benthacher/alarmbot/README.md

# Alarmbot project

## Alarmbot PCB

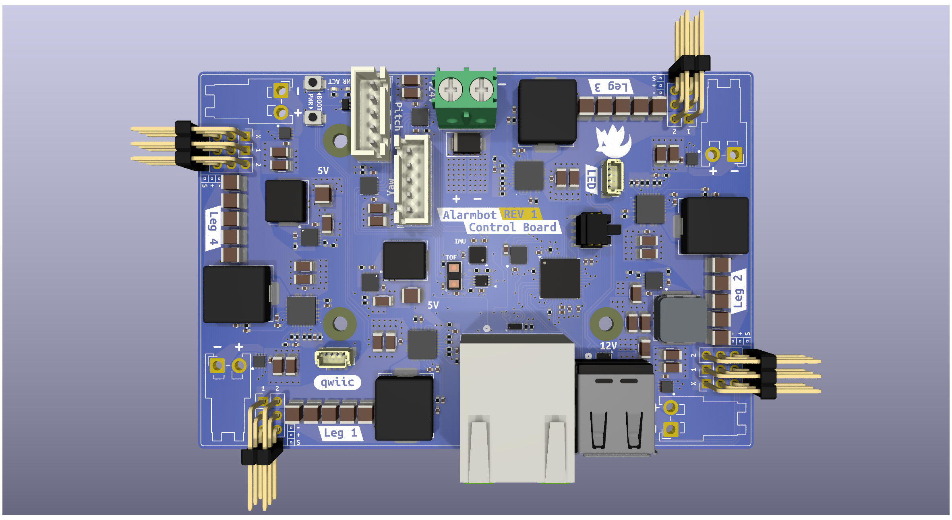
[picture p1: pcb/alarmbot.png]
alarmbot
