benthacher/alarmbot/pcb/alarmbot.kicad_pcb

## KiCad design pcb/alarmbot.kicad_pcb (2025-03-19)

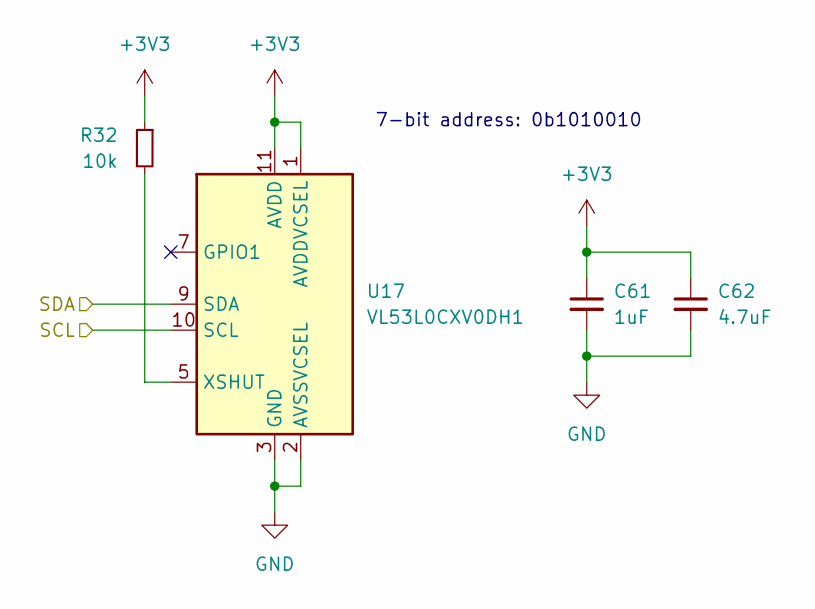
[picture p2: schematic tof.kicad_sch]

Parts:
C61: 1uF; C_0402_1005Metric; LCSC C52923
C62: 4.7uF; C_0402_1005Metric; LCSC C23733
R32: 10k; R_0402_1005Metric; LCSC C25744
U17: VL53L0CXV0DH1; ST_VL53L1x; LCSC C91199

Connections:
+3V3: C61.1, C62.1, R32.1, U17.1 (AVDDVCSEL), U17.11 (AVDD); also elsewhere on the board
/MCU/I2C2_SCL: U17.10 (SCL); also elsewhere on the board
/MCU/I2C2_SDA: U17.9 (SDA); also elsewhere on the board
GND: C61.2, C62.2, U17.2 (AVSSVCSEL), U17.3 (GND), U17.4 (GND), U17.6 (GND), U17.12 (GND); also elsewhere on the board
unnamed: R32.2, U17.5 (XSHUT)

Notes on the sheet:
7-bit address: 0b1010010

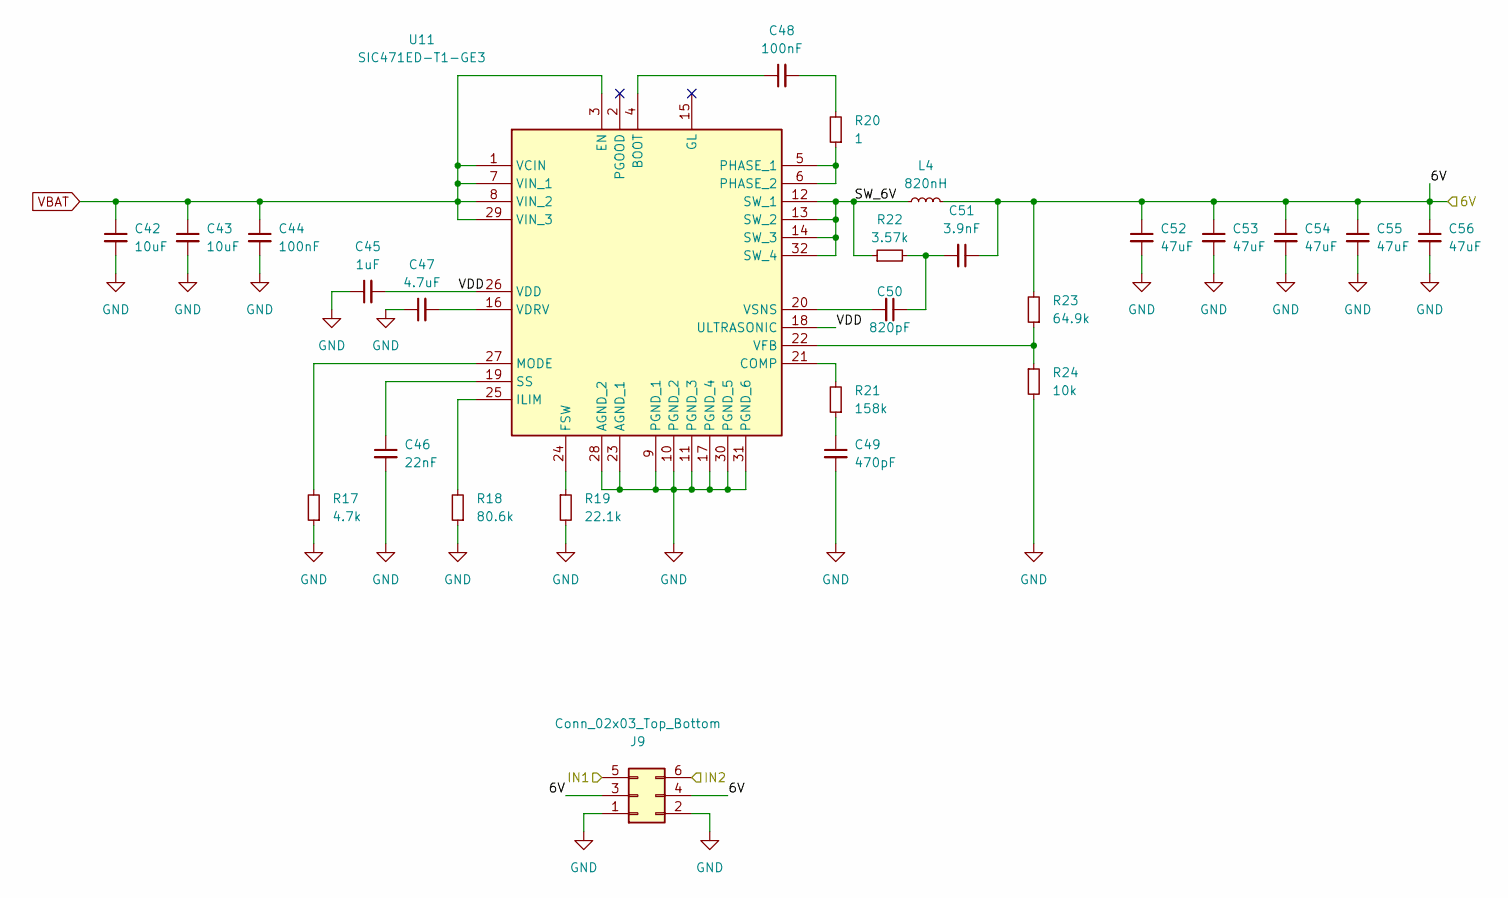
[picture p3: schematic shoulder.kicad_sch]

Parts:
C42, C43: 10uF; C_1206_3216Metric; LCSC C13585
C44, C48: 100nF; C_0402_1005Metric; Voltage 50V; LCSC C307331
C45: 1uF; C_0402_1005Metric; LCSC C52923
C46: 22nF; C_0402_1005Metric; LCSC C1532
C47: 4.7uF; C_0402_1005Metric; LCSC C23733
C49: 470pF; C_0402_1005Metric; LCSC C1537
C50: 820pF; C_0402_1005Metric; LCSC C107031
C51: 3.9nF; C_0402_1005Metric; LCSC C45188
C52, C53, C54, C55, C56: 47uF; C_1210_3225Metric; LCSC C5440143
J9: Conn_02x03_Top_Bottom; PinHeader_2x03_P2.54mm_Vertical
L4: 820nH; CMPI1040; LCSC C7588944
R17: 4.7k; R_0402_1005Metric; LCSC C25900
R18: 80.6k; R_0402_1005Metric; LCSC C25921
R19: 22.1k; R_0402_1005Metric; LCSC C43473
R20: 1; R_0402_1005Metric; LCSC C25086
R21: 158k; R_0402_1005Metric; LCSC C185464
R22: 3.57k; R_0402_1005Metric; LCSC C3037168
R23: 64.9k; R_0402_1005Metric; LCSC C5713275
R24: 10k; R_0402_1005Metric; LCSC C25744
U11: SIC471ED-T1-GE3; SIC471EDT1GE3; Manufacturer_Part_Number SIC471ED-T1-GE3; Mouser Part Number 78-SIC471ED-T1-GE3

Connections:
/MCU/TIM2_CH1: J9.5; also elsewhere on the board
/MCU/TIM2_CH2: J9.6; also elsewhere on the board
/Shoulder1/6V: C51.1, C52.1, C53.1, C54.1, C55.1, C56.1, J9.3, J9.4, L4.2, R23.2
/Shoulder1/SW_6V: L4.1, R22.1, U11.12 (SW_1), U11.13 (SW_2), U11.14 (SW_3), U11.32 (SW_4)
/Shoulder1/VDD: C45.2, U11.18 (ULTRASONIC), U11.26 (VDD)
GND: C42.2, C43.2, C44.2, C45.1, C46.2, C47.1, C49.2, C52.2, C53.2, C54.2, C55.2, C56.2, J9.1, J9.2, R17.1, R18.1, R19.2, R24.2, U11.9 (PGND_1), U11.10 (PGND_2), U11.11 (PGND_3), U11.17 (PGND_4), U11.23 (AGND_1), U11.28 (AGND_2), U11.30 (PGND_5), U11.31 (PGND_6); also elsewhere on the board
unnamed: C48.2, R20.2
unnamed: C49.1, R21.1
unnamed: C50.1, C51.2, R22.2
unnamed: C48.1, U11.4 (BOOT)
unnamed: R21.2, U11.21 (COMP)
unnamed: R19.1, U11.24 (FSW)
unnamed: R18.2, U11.25 (ILIM)
unnamed: R17.2, U11.27 (MODE)
unnamed: R20.1, U11.5 (PHASE_1), U11.6 (PHASE_2)
unnamed: C46.1, U11.19 (SS)
unnamed: C47.2, U11.16 (VDRV)
unnamed: R23.1, R24.1, U11.22 (VFB)
unnamed: C50.2, U11.20 (VSNS)
VBAT: C42.1, C43.1, C44.1, U11.1 (VCIN), U11.3 (EN), U11.7 (VIN_1), U11.8 (VIN_2), U11.29 (VIN_3); also elsewhere on the board

Parts of its further copies:
C63, C64, C78, C79, C93, C94: 10uF; C_1206_3216Metric; LCSC C13585
C65, C69, C80, C84, C95, C99: 100nF; C_0402_1005Metric; Voltage 50V; LCSC C307331
C66, C81, C96: 1uF; C_0402_1005Metric; LCSC C52923
C67, C82, C97: 22nF; C_0402_1005Metric; LCSC C1532
C68, C83, C98: 4.7uF; C_0402_1005Metric; LCSC C23733
C70, C85, C100: 470pF; C_0402_1005Metric; LCSC C1537
C71, C86, C101: 820pF; C_0402_1005Metric; LCSC C107031
C72, C87, C102: 3.9nF; C_0402_1005Metric; LCSC C45188
C73, C74, C75, C76, C77, C88, C89, C90, C91, C92, C103, C104, C105, C106, C107: 47uF; C_1210_3225Metric; LCSC C5440143
J13, J14, J15: Conn_02x03_Top_Bottom; PinHeader_2x03_P2.54mm_Vertical
L5, L6, L7: 820nH; CMPI1040; LCSC C7588944
R33, R41, R49: 4.7k; R_0402_1005Metric; LCSC C25900
R34, R42, R50: 80.6k; R_0402_1005Metric; LCSC C25921
R35, R43, R51: 22.1k; R_0402_1005Metric; LCSC C43473
R36, R44, R52: 1; R_0402_1005Metric; LCSC C25086
R37, R45, R53: 158k; R_0402_1005Metric; LCSC C185464
R38, R46, R54: 3.57k; R_0402_1005Metric; LCSC C3037168
R39, R47, R55: 64.9k; R_0402_1005Metric; LCSC C5713275
R40, R48, R56: 10k; R_0402_1005Metric; LCSC C25744
U18, U19, U20: SIC471ED-T1-GE3; SIC471EDT1GE3; Manufacturer_Part_Number SIC471ED-T1-GE3; Mouser Part Number 78-SIC471ED-T1-GE3

Connections of its further copies:
/MCU/TIM1_CH1: J14.5; also elsewhere on the board
/MCU/TIM1_CH2: J14.6; also elsewhere on the board
/MCU/TIM1_CH3: J15.5; also elsewhere on the board
/MCU/TIM1_CH4: J15.6; also elsewhere on the board
/MCU/TIM2_CH3: J13.5; also elsewhere on the board
/MCU/TIM2_CH4: J13.6; also elsewhere on the board
/Shoulder2/6V: C72.1, C73.1, C74.1, C75.1, C76.1, C77.1, J13.3, J13.4, L5.2, R39.2; also elsewhere on the board
/Shoulder2/SW_6V: L5.1, R38.1, U18.12 (SW_1), U18.13 (SW_2), U18.14 (SW_3), U18.32 (SW_4)
/Shoulder2/VDD: C66.2, U18.18 (ULTRASONIC), U18.26 (VDD)
/Shoulder3/6V: C87.1, C88.1, C89.1, C90.1, C91.1, C92.1, J14.3, J14.4, L6.2, R47.2
/Shoulder3/SW_6V: L6.1, R46.1, U19.12 (SW_1), U19.13 (SW_2), U19.14 (SW_3), U19.32 (SW_4)
/Shoulder3/VDD: C81.2, U19.18 (ULTRASONIC), U19.26 (VDD)
/Shoulder4/6V: C102.1, C103.1, C104.1, C105.1, C106.1, C107.1, J15.3, J15.4, L7.2, R55.2; also elsewhere on the board
/Shoulder4/SW_6V: L7.1, R54.1, U20.12 (SW_1), U20.13 (SW_2), U20.14 (SW_3), U20.32 (SW_4)
/Shoulder4/VDD: C96.2, U20.18 (ULTRASONIC), U20.26 (VDD)
GND: C63.2, C64.2, C65.2, C66.1, C67.2, C68.1, C70.2, C73.2, C74.2, C75.2, C76.2, C77.2, C78.2, C79.2, C80.2, C81.1, C82.2, C83.1, C85.2, C88.2, C89.2, C90.2, C91.2, C92.2, C93.2, C94.2, C95.2, C96.1, C97.2, C98.1, C100.2, C103.2, C104.2, C105.2, C106.2, C107.2, J13.1, J13.2, J14.1, J14.2, J15.1, J15.2, R33.1, R34.1, R35.2, R40.2, R41.1, R42.1, R43.2, R48.2, R49.1, R50.1, R51.2, R56.2, U18.9 (PGND_1), U18.10 (PGND_2), U18.11 (PGND_3), U18.17 (PGND_4), U18.23 (AGND_1), U18.28 (AGND_2), U18.30 (PGND_5), U18.31 (PGND_6), U19.9 (PGND_1), U19.10 (PGND_2), U19.11 (PGND_3), U19.17 (PGND_4), U19.23 (AGND_1), U19.28 (AGND_2), U19.30 (PGND_5), U19.31 (PGND_6), U20.9 (PGND_1), U20.10 (PGND_2), U20.11 (PGND_3), U20.17 (PGND_4), U20.23 (AGND_1), U20.28 (AGND_2), U20.30 (PGND_5), U20.31 (PGND_6); also elsewhere on the board
unnamed: C69.2, R36.2
unnamed: C70.1, R37.1
unnamed: C71.1, C72.2, R38.2
unnamed: C84.2, R44.2
unnamed: C85.1, R45.1
unnamed: C86.1, C87.2, R46.2
unnamed: C99.2, R52.2
unnamed: C100.1, R53.1
unnamed: C101.1, C102.2, R54.2
unnamed: C69.1, U18.4 (BOOT)
unnamed: R37.2, U18.21 (COMP)
unnamed: R35.1, U18.24 (FSW)
unnamed: R34.2, U18.25 (ILIM)
unnamed: R33.2, U18.27 (MODE)
unnamed: R36.1, U18.5 (PHASE_1), U18.6 (PHASE_2)
unnamed: C67.1, U18.19 (SS)
unnamed: C68.2, U18.16 (VDRV)
unnamed: R39.1, R40.1, U18.22 (VFB)
unnamed: C71.2, U18.20 (VSNS)
unnamed: C84.1, U19.4 (BOOT)
unnamed: R45.2, U19.21 (COMP)
unnamed: R43.1, U19.24 (FSW)
unnamed: R42.2, U19.25 (ILIM)
unnamed: R41.2, U19.27 (MODE)
unnamed: R44.1, U19.5 (PHASE_1), U19.6 (PHASE_2)
unnamed: C82.1, U19.19 (SS)
unnamed: C83.2, U19.16 (VDRV)
unnamed: R47.1, R48.1, U19.22 (VFB)
unnamed: C86.2, U19.20 (VSNS)
unnamed: C99.1, U20.4 (BOOT)
unnamed: R53.2, U20.21 (COMP)
unnamed: R51.1, U20.24 (FSW)
unnamed: R50.2, U20.25 (ILIM)
unnamed: R49.2, U20.27 (MODE)
unnamed: R52.1, U20.5 (PHASE_1), U20.6 (PHASE_2)
unnamed: C97.1, U20.19 (SS)
unnamed: C98.2, U20.16 (VDRV)
unnamed: R55.1, R56.1, U20.22 (VFB)
unnamed: C101.2, U20.20 (VSNS)
VBAT: C63.1, C64.1, C65.1, C78.1, C79.1, C80.1, C93.1, C94.1, C95.1, U18.1 (VCIN), U18.3 (EN), U18.7 (VIN_1), U18.8 (VIN_2), U18.29 (VIN_3), U19.1 (VCIN), U19.3 (EN), U19.7 (VIN_1), U19.8 (VIN_2), U19.29 (VIN_3), U20.1 (VCIN), U20.3 (EN), U20.7 (VIN_1), U20.8 (VIN_2), U20.29 (VIN_3); also elsewhere on the board

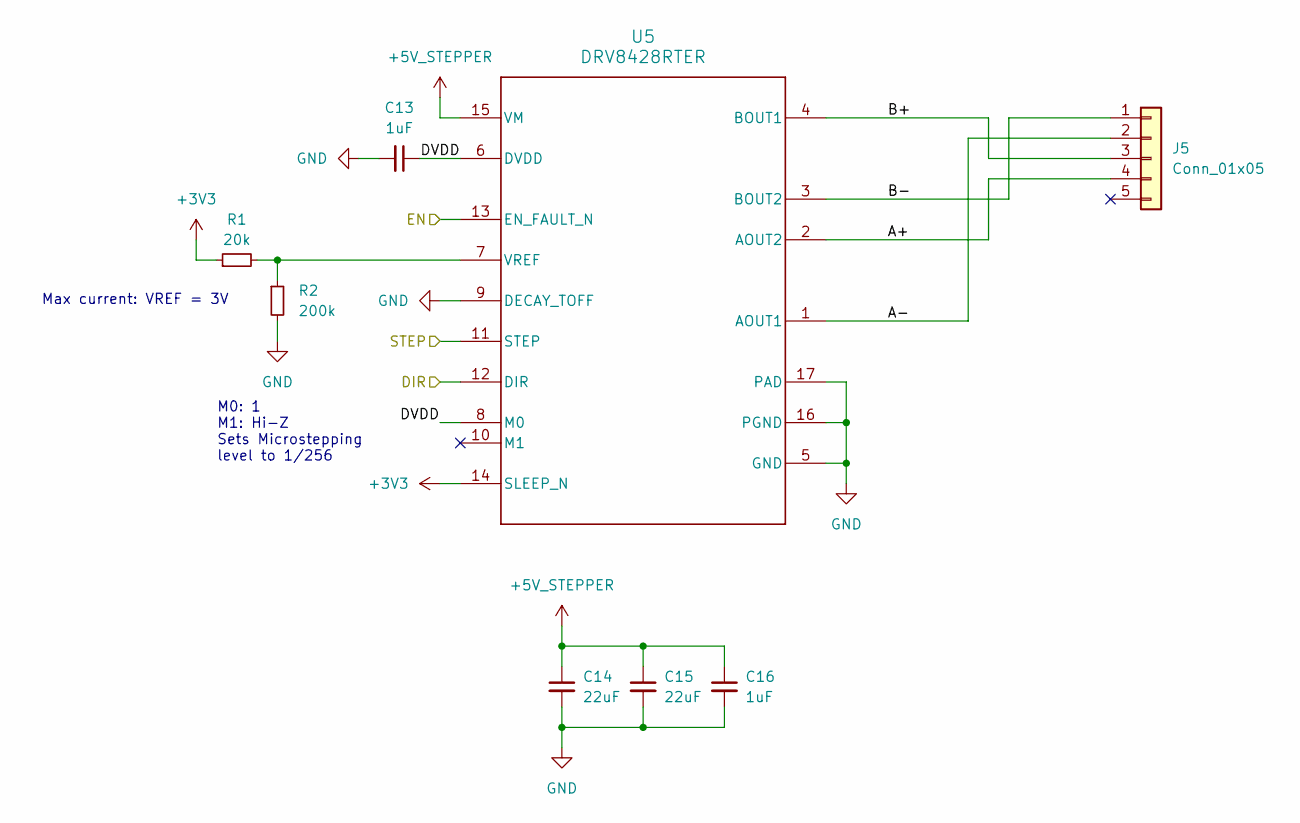
[picture p4: schematic stepper_motor_driver.kicad_sch]

Parts:
C13, C16: 1uF; C_0402_1005Metric; LCSC C52923
C14, C15: 22uF; C_1206_3216Metric; LCSC C12891
J5: Conn_01x05; JST_XH_B5B-XH-A_1x05_P2.50mm_Vertical
R1: 20k; R_0402_1005Metric; LCSC C25765
R2: 200k; R_0402_1005Metric; LCSC C25764
U5: DRV8428RTER; RTE0016J; LCSC C2857955

Connections:
+3V3: R1.1, U5.14 (SLEEP_N); also elsewhere on the board
+5V_STEPPER: C14.1, C15.1, C16.1, U5.15 (VM); also elsewhere on the board
/MCU/HEAD_PITCH_DIR: U5.12 (DIR); also elsewhere on the board
/MCU/HEAD_PITCH_EN: U5.13 (EN_FAULT_N); also elsewhere on the board
/MCU/TIM17_CH1: U5.11 (STEP); also elsewhere on the board
/Stepper1/A+: J5.4, U5.2 (AOUT2)
/Stepper1/A-: J5.2, U5.1 (AOUT1)
/Stepper1/B+: J5.3, U5.4 (BOUT1)
/Stepper1/B-: J5.1, U5.3 (BOUT2)
/Stepper1/DVDD: C13.1, U5.6 (DVDD), U5.8 (M0)
GND: C13.2, C14.2, C15.2, C16.2, R2.2, U5.5 (GND), U5.9 (DECAY_TOFF), U5.16 (PGND), U5.17 (PAD); also elsewhere on the board
unnamed: R1.2, R2.1, U5.7 (VREF)

Parts of its further copies:
C24, C27: 1uF; C_0402_1005Metric; LCSC C52923
C25, C26: 22uF; C_1206_3216Metric; LCSC C12891
J7: Conn_01x05; JST_XH_B5B-XH-A_1x05_P2.50mm_Vertical
R6: 20k; R_0402_1005Metric; LCSC C25765
R7: 200k; R_0402_1005Metric; LCSC C25764
U7: DRV8428RTER; RTE0016J; LCSC C2857955

Connections of its further copies:
+3V3: R6.1, U7.14 (SLEEP_N); also elsewhere on the board
+5V_STEPPER: C25.1, C26.1, C27.1, U7.15 (VM); also elsewhere on the board
/MCU/HEAD_YAW_DIR: U7.12 (DIR); also elsewhere on the board
/MCU/HEAD_YAW_EN: U7.13 (EN_FAULT_N); also elsewhere on the board
/MCU/TIM16_CH1: U7.11 (STEP); also elsewhere on the board
/Stepper2/A+: J7.4, U7.2 (AOUT2)
/Stepper2/A-: J7.2, U7.1 (AOUT1)
/Stepper2/B+: J7.3, U7.4 (BOUT1)
/Stepper2/B-: J7.1, U7.3 (BOUT2)
/Stepper2/DVDD: C24.1, U7.6 (DVDD), U7.8 (M0)
GND: C24.2, C25.2, C26.2, C27.2, R7.2, U7.5 (GND), U7.9 (DECAY_TOFF), U7.16 (PGND), U7.17 (PAD); also elsewhere on the board
unnamed: R6.2, R7.1, U7.7 (VREF)

Notes on the sheet:
M0: 1 M1: Hi-Z Sets Microstepping level to 1/256
Max current: VREF = 3V

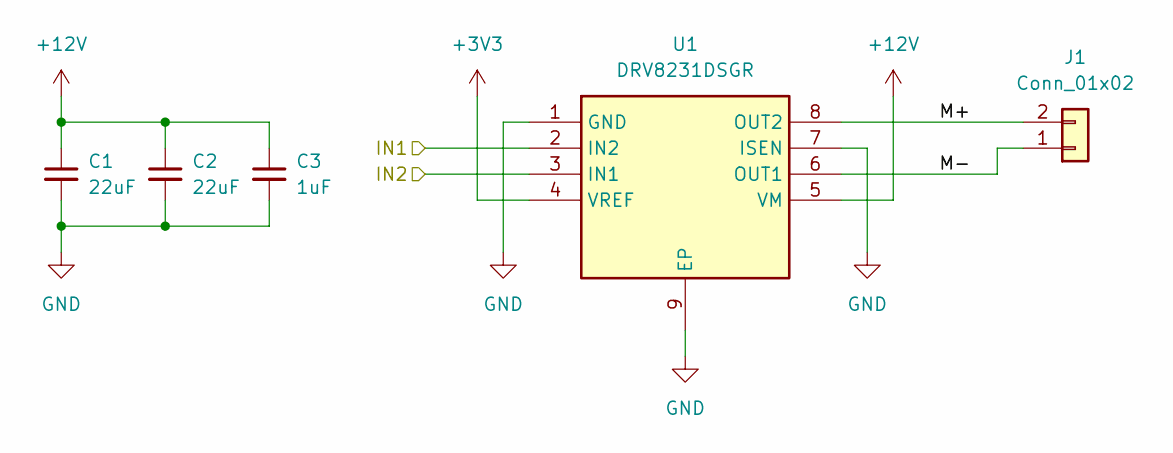
[picture p5: schematic wheel_motor_drive.kicad_sch]

Parts:
C1, C2: 22uF; C_1206_3216Metric; LCSC C12891
C3: 1uF; C_0402_1005Metric; LCSC C52923
J1: Conn_01x02; JST_VH_S2P-VH_1x02_P3.96mm_Horizontal; LCSC C158007
U1: DRV8231DSGR; SON50P200X200X80-9N; Manufacturer_Part_Number DRV8231DSGR; Mouser Part Number 595-DRV8231DSGR

Connections:
+3V3: U1.4 (VREF); also elsewhere on the board
+12V: C1.1, C2.1, C3.1, U1.5 (VM); also elsewhere on the board
/MCU/TIM3_CH1: U1.2 (IN2); also elsewhere on the board
/MCU/TIM3_CH2: U1.3 (IN1); also elsewhere on the board
/Wheel1/M+: J1.2, U1.8 (OUT2)
/Wheel1/M-: J1.1, U1.6 (OUT1)
GND: C1.2, C2.2, C3.2, U1.1 (GND), U1.7 (ISEN), U1.9 (EP); also elsewhere on the board

Parts of its further copies:
C4, C5, C7, C8, C10, C11: 22uF; C_1206_3216Metric; LCSC C12891
C6, C9, C12: 1uF; C_0402_1005Metric; LCSC C52923
J2, J3, J4: Conn_01x02; JST_VH_S2P-VH_1x02_P3.96mm_Horizontal; LCSC C158007
U2, U3, U4: DRV8231DSGR; SON50P200X200X80-9N; Manufacturer_Part_Number DRV8231DSGR; Mouser Part Number 595-DRV8231DSGR

Connections of its further copies:
+3V3: U2.4 (VREF), U3.4 (VREF), U4.4 (VREF); also elsewhere on the board
+12V: C4.1, C5.1, C6.1, C7.1, C8.1, C9.1, C10.1, C11.1, C12.1, U2.5 (VM), U3.5 (VM), U4.5 (VM); also elsewhere on the board
/MCU/TIM3_CH3: U2.2 (IN2); also elsewhere on the board
/MCU/TIM3_CH4: U2.3 (IN1); also elsewhere on the board
/MCU/TIM4_CH1: U3.2 (IN2); also elsewhere on the board
/MCU/TIM4_CH2: U3.3 (IN1); also elsewhere on the board
/MCU/TIM4_CH3: U4.2 (IN2); also elsewhere on the board
/MCU/TIM4_CH4: U4.3 (IN1); also elsewhere on the board
/Wheel2/M+: J2.2, U2.8 (OUT2)
/Wheel2/M-: J2.1, U2.6 (OUT1)
/Wheel3/M+: J3.2, U3.8 (OUT2)
/Wheel3/M-: J3.1, U3.6 (OUT1)
/Wheel4/M+: J4.2, U4.8 (OUT2)
/Wheel4/M-: J4.1, U4.6 (OUT1)
GND: C4.2, C5.2, C6.2, C7.2, C8.2, C9.2, C10.2, C11.2, C12.2, U2.1 (GND), U2.7 (ISEN), U2.9 (EP), U3.1 (GND), U3.7 (ISEN), U3.9 (EP), U4.1 (GND), U4.7 (ISEN), U4.9 (EP); also elsewhere on the board

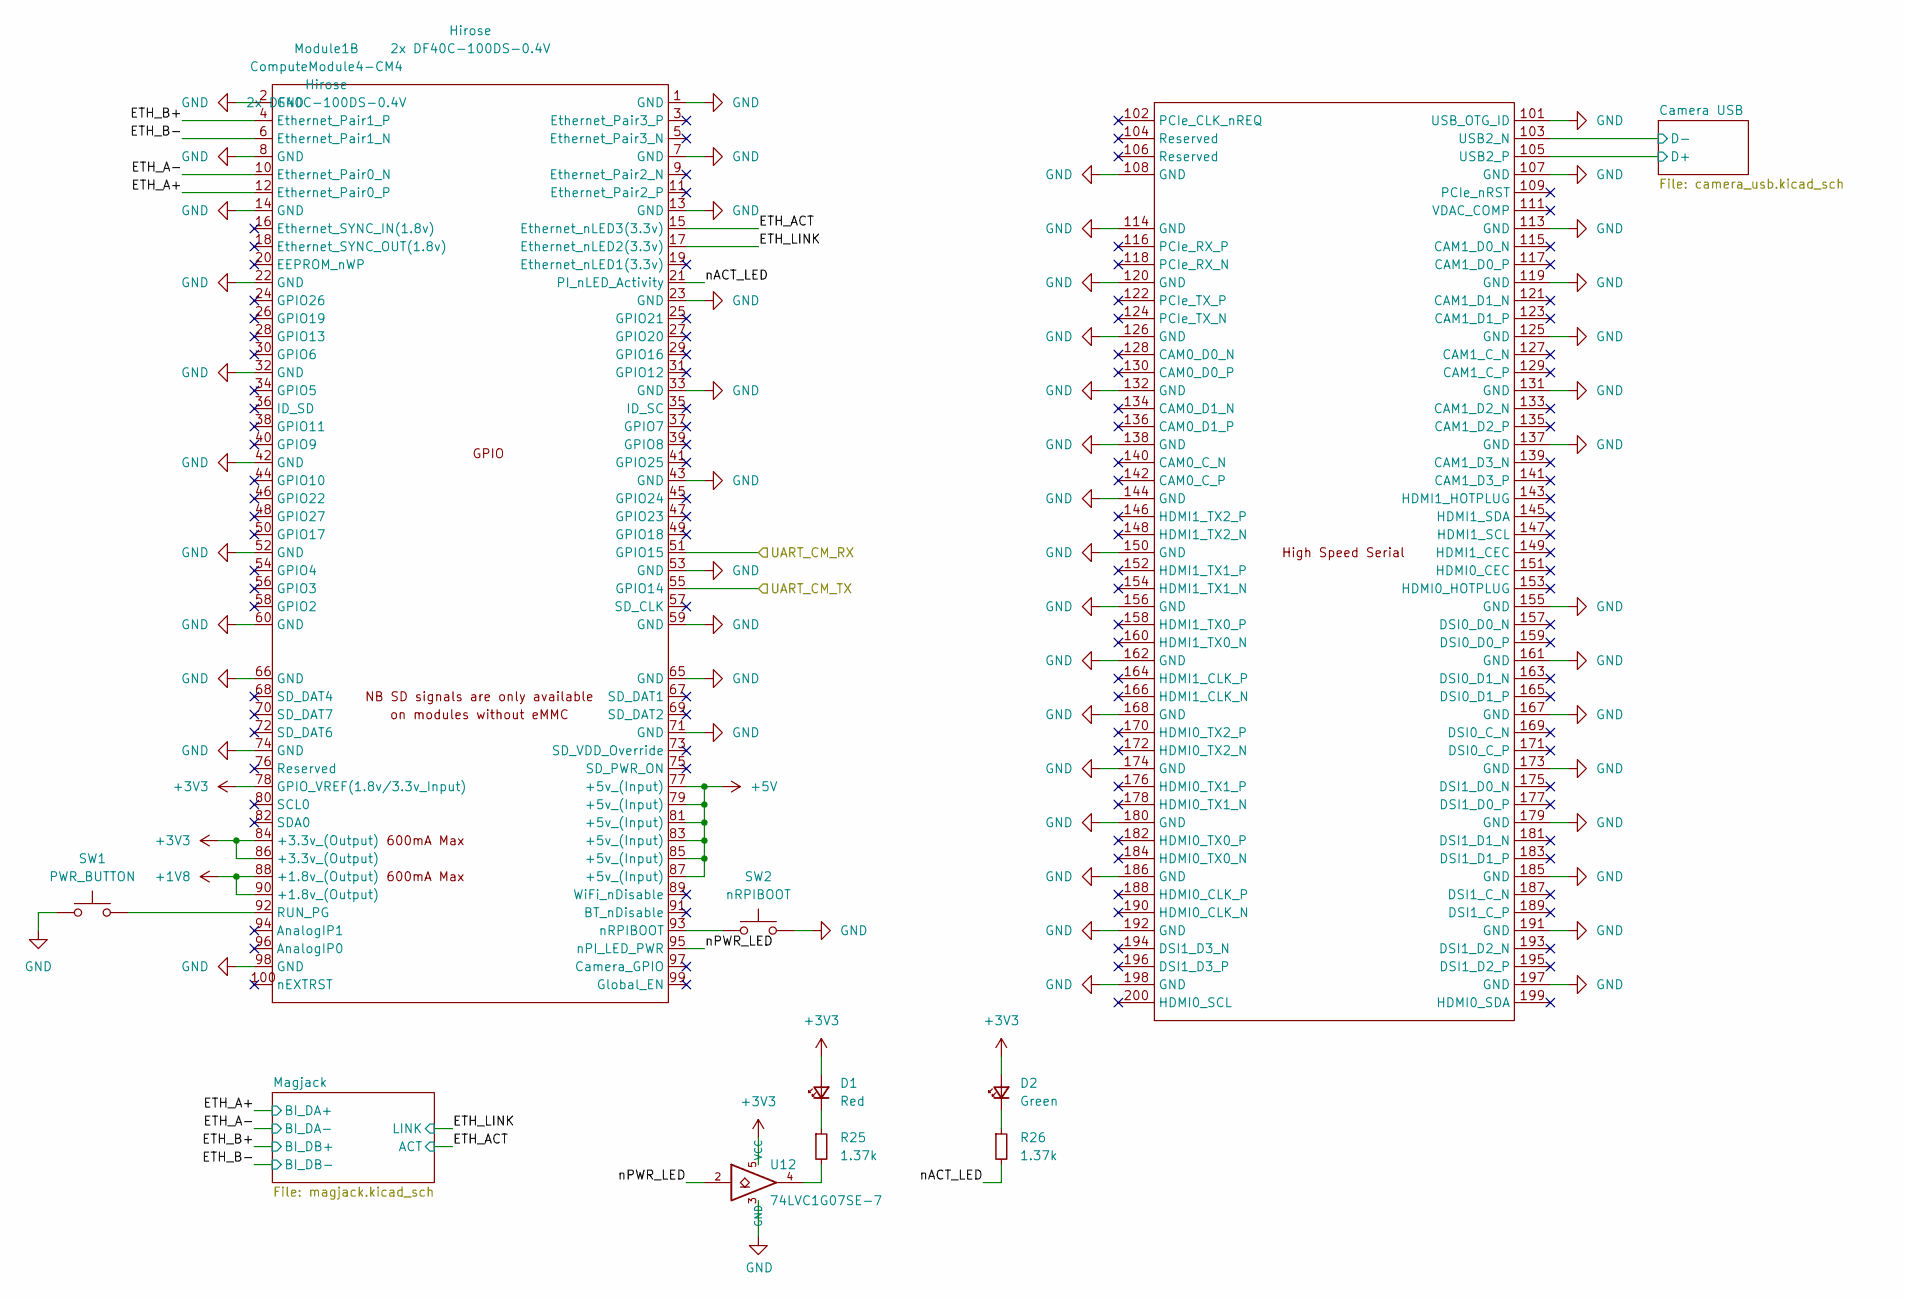
[picture p6: schematic cm5.kicad_sch]

Parts:
D1: Red; LED_0402_1005Metric; LCSC C264407
D2: Green; LED_0402_1005Metric; LCSC C401111
Module1: ComputeModule4-CM4; Raspberry-Pi-4-Compute-Module
R25, R26: 1.37k; R_0402_1005Metric; LCSC C321297
SW1: PWR_BUTTON; TL1017ABAF160QG
SW2: nRPIBOOT; TL1017ABAF160QG
U12: 74LVC1G07SE-7; SOT-353_SC-70-5; Part Description Buffer, Non-Inverting 1 Element 1 Bit p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; LCSC C264081

Connections:
+1V8: Module1.88 (+1.8v_(Output)), Module1.90 (+1.8v_(Output)); also elsewhere on the board
+3V3: D1.2 (A), D2.2 (A), Module1.78 (GPIO_VREF(1.8v/3.3v_Input)), Module1.84 (+3.3v_(Output)), Module1.86 (+3.3v_(Output)), U12.5 (VCC); also elsewhere on the board
+5V: Module1.77 (+5v_(Input)), Module1.79 (+5v_(Input)), Module1.81 (+5v_(Input)), Module1.83 (+5v_(Input)), Module1.85 (+5v_(Input)), Module1.87 (+5v_(Input)); also elsewhere on the board
/MCU/USART3_RX: Module1.55 (GPIO14); also elsewhere on the board
/MCU/USART3_TX: Module1.51 (GPIO15); also elsewhere on the board
/cm5/Camera USB/D+: Module1.105 (USB2_P); also elsewhere on the board
/cm5/Camera USB/D-: Module1.103 (USB2_N); also elsewhere on the board
/cm5/ETH_A+: Module1.12 (Ethernet_Pair0_P); also elsewhere on the board
/cm5/ETH_A-: Module1.10 (Ethernet_Pair0_N); also elsewhere on the board
/cm5/ETH_ACT: Module1.15 (Ethernet_nLED3(3.3v)); also elsewhere on the board
/cm5/ETH_B+: Module1.4 (Ethernet_Pair1_P); also elsewhere on the board
/cm5/ETH_B-: Module1.6 (Ethernet_Pair1_N); also elsewhere on the board
/cm5/ETH_LINK: Module1.17 (Ethernet_nLED2(3.3v)); also elsewhere on the board
/cm5/nACT_LED: Module1.21 (PI_nLED_Activity), R26.2
/cm5/nPWR_LED: Module1.95 (nPI_LED_PWR), U12.2
GND: Module1.1 (GND), Module1.2 (GND), Module1.7 (GND), Module1.8 (GND), Module1.13 (GND), Module1.14 (GND), Module1.22 (GND), Module1.23 (GND), Module1.32 (GND), Module1.33 (GND), Module1.42 (GND), Module1.43 (GND), Module1.52 (GND), Module1.53 (GND), Module1.59 (GND), Module1.60 (GND), Module1.65 (GND), Module1.66 (GND), Module1.71 (GND), Module1.74 (GND), Module1.98 (GND), Module1.101 (USB_OTG_ID), Module1.107 (GND), Module1.108 (GND), Module1.113 (GND), Module1.114 (GND), Module1.119 (GND), Module1.120 (GND), Module1.125 (GND), Module1.126 (GND), Module1.131 (GND), Module1.132 (GND), Module1.137 (GND), Module1.138 (GND), Module1.144 (GND), Module1.150 (GND), Module1.155 (GND), Module1.156 (GND), Module1.161 (GND), Module1.162 (GND), Module1.167 (GND), Module1.168 (GND), Module1.173 (GND), Module1.174 (GND), Module1.179 (GND), Module1.180 (GND), Module1.185 (GND), Module1.186 (GND), Module1.191 (GND), Module1.192 (GND), Module1.197 (GND), Module1.198 (GND), SW1.1, SW2.2, U12.3 (GND); also elsewhere on the board
unnamed: D1.1 (K), R25.1
unnamed: D2.1 (K), R26.1
unnamed: Module1.92 (RUN_PG), SW1.2
unnamed: Module1.93 (nRPIBOOT), SW2.1
unnamed: R25.2, U12.4

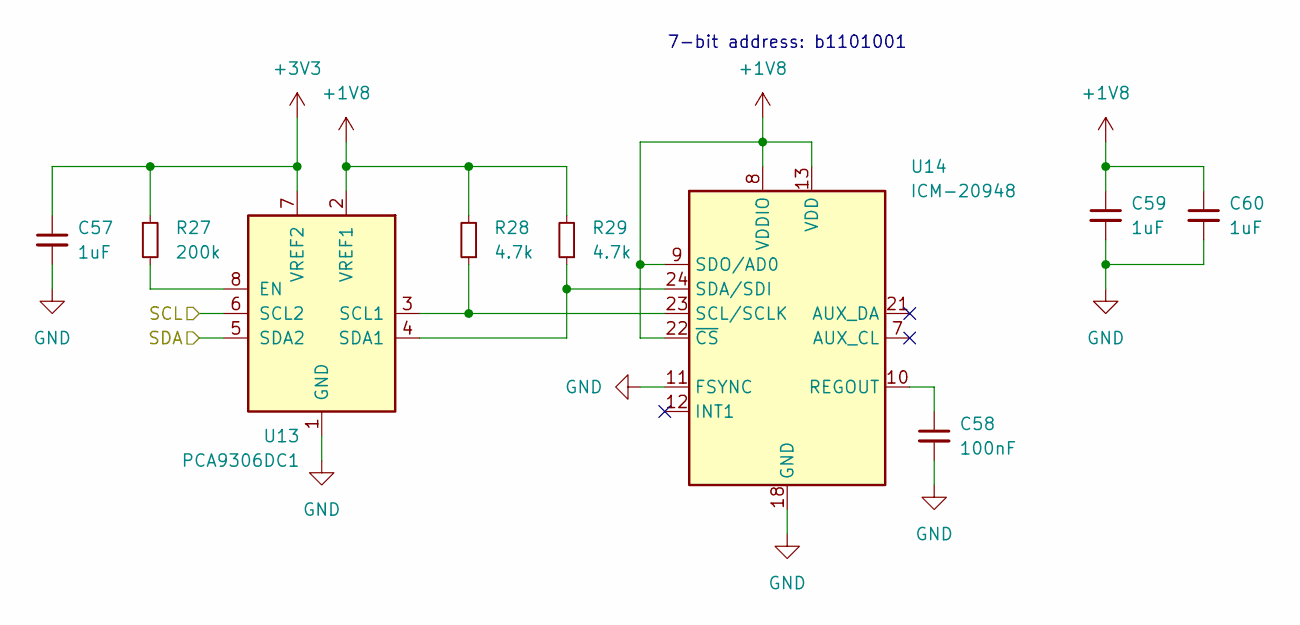
[picture p7: schematic imu.kicad_sch]

Parts:
C57, C59, C60: 1uF; C_0402_1005Metric; LCSC C52923
C58: 100nF; C_0402_1005Metric; Voltage 50V; LCSC C307331
R27: 200k; R_0402_1005Metric; LCSC C25764
R28, R29: 4.7k; R_0402_1005Metric; LCSC C25900
U13: PCA9306DC1; VSSOP-8_2.3x2mm_P0.5mm; LCSC C129510
U14: ICM-20948; InvenSense_QFN-24_3x3mm_P0.4mm; LCSC C726001

Connections:
+1V8: C59.1, C60.1, R28.2, R29.2, U13.2 (VREF1), U14.8 (VDDIO), U14.9 (SDO/AD0), U14.13 (VDD), U14.22 (~CS); also elsewhere on the board
+3V3: C57.1, R27.1, U13.7 (VREF2); also elsewhere on the board
/MCU/I2C2_SCL: U13.6 (SCL2); also elsewhere on the board
/MCU/I2C2_SDA: U13.5 (SDA2); also elsewhere on the board
GND: C57.2, C58.2, C59.2, C60.2, U13.1 (GND), U14.11 (FSYNC), U14.18 (GND), U14.20 (GND); also elsewhere on the board
unnamed: R27.2, U13.8 (EN)
unnamed: R28.1, U13.3 (SCL1), U14.23 (SCL/SCLK)
unnamed: R29.1, U13.4 (SDA1), U14.24 (SDA/SDI)
unnamed: C58.1, U14.10 (REGOUT)

Notes on the sheet:
7-bit address: b1101001

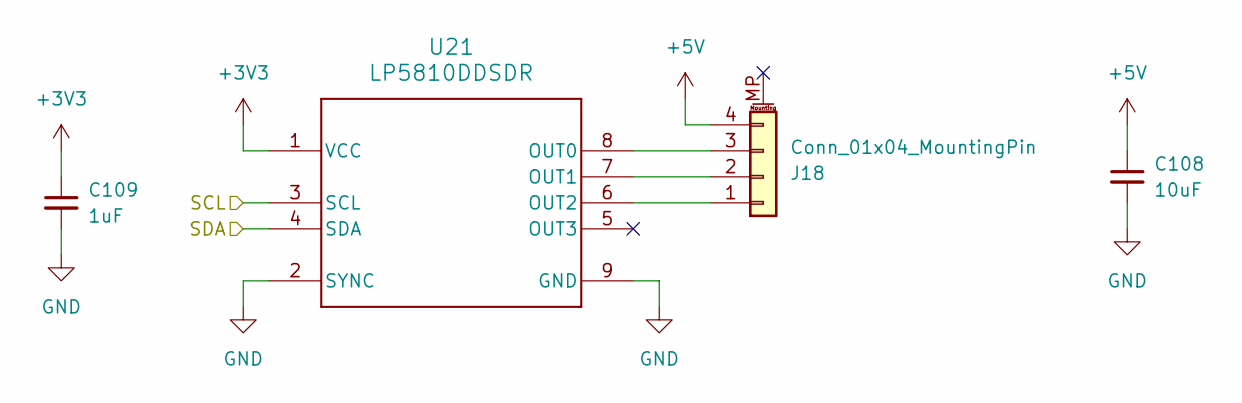
[picture p8: schematic led.kicad_sch]

Parts:
C108: 10uF; C_0603_1608Metric; Voltage 10V; LCSC C19702
C109: 1uF; C_0402_1005Metric; LCSC C52923
J18: Conn_01x04_MountingPin; JST_SH_BM04B-SRSS-TB_1x04-1MP_P1.00mm_Vertical; LCSC C160390
U21: LP5810DDSDR; DSD0008B-IPC_A; LCSC C32392783

Connections:
+3V3: C109.1, U21.1 (VCC); also elsewhere on the board
+5V: C108.1, J18.4; also elsewhere on the board
/MCU/I2C2_SCL: U21.3 (SCL); also elsewhere on the board
/MCU/I2C2_SDA: U21.4 (SDA); also elsewhere on the board
GND: C108.2, C109.2, U21.2 (SYNC), U21.9 (GND); also elsewhere on the board
unnamed: J18.1, U21.6 (OUT2)
unnamed: J18.2, U21.7 (OUT1)
unnamed: J18.3, U21.8 (OUT0)

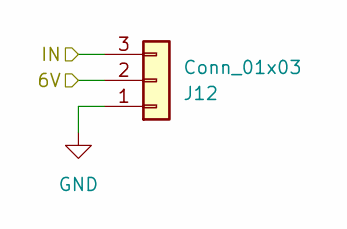
[picture p9: schematic aux_servo.kicad_sch]

Parts:
J12: Conn_01x03; PinHeader_1x03_P2.54mm_Vertical

Connections:
/MCU/TIM15_CH1: J12.3; also elsewhere on the board
/Shoulder2/6V: J12.2; also elsewhere on the board
GND: J12.1; also elsewhere on the board

Parts of its further copies:
J16: Conn_01x03; PinHeader_1x03_P2.54mm_Vertical

Connections of its further copies:
/MCU/TIM15_CH2: J16.3; also elsewhere on the board
/Shoulder4/6V: J16.2; also elsewhere on the board
GND: J16.1; also elsewhere on the board

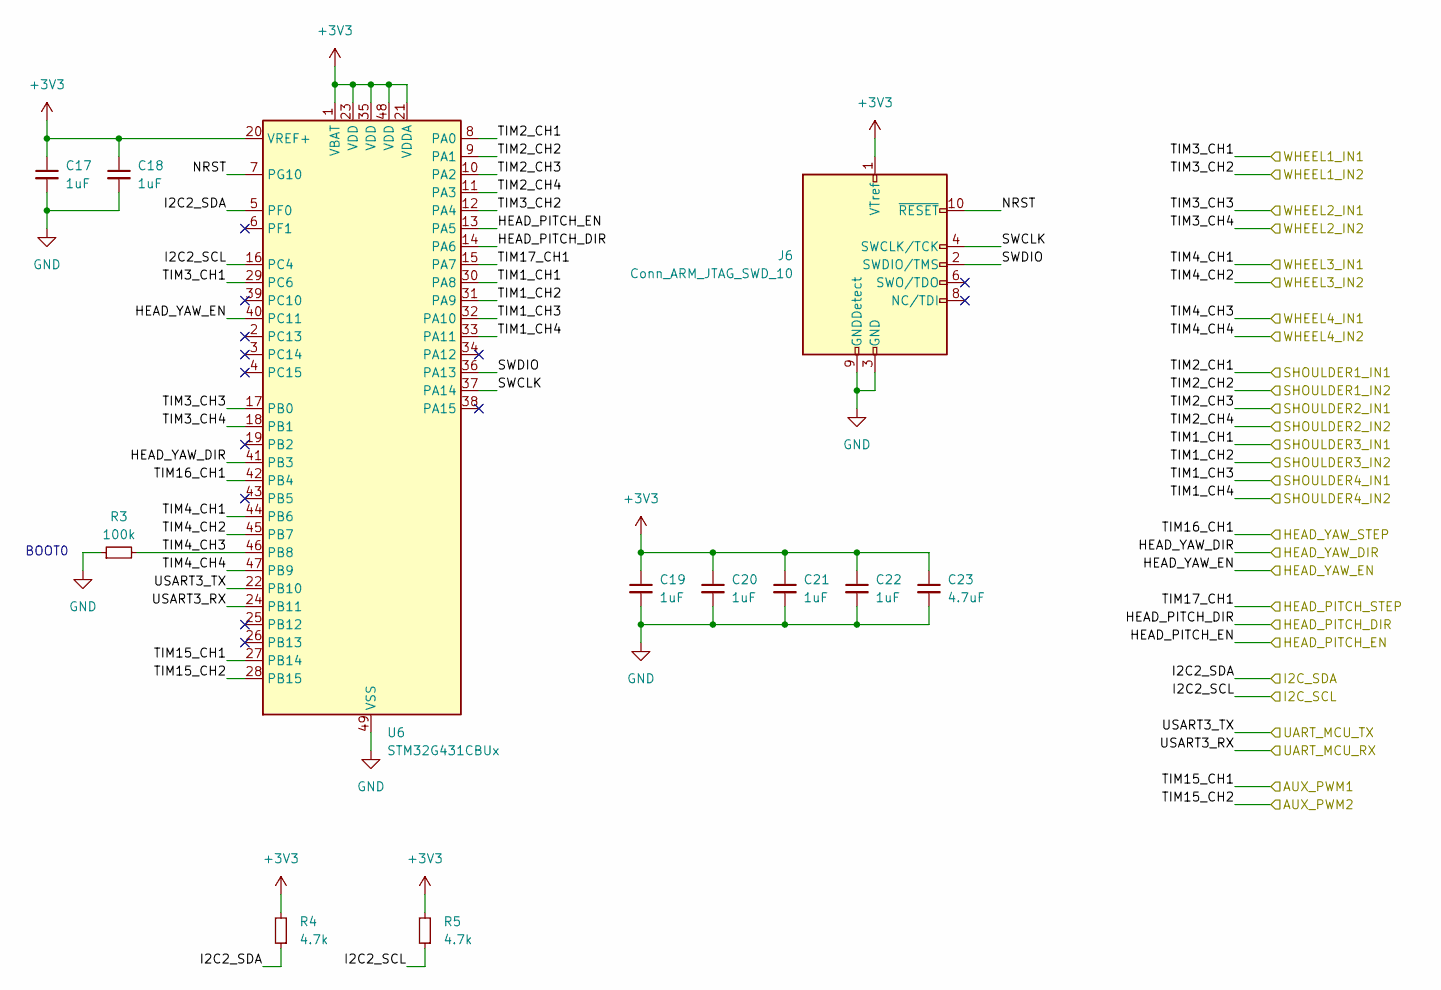
[picture p10: schematic mcu.kicad_sch]

Parts:
C17, C18, C19, C20, C21, C22: 1uF; C_0402_1005Metric; LCSC C52923
C23: 4.7uF; C_0402_1005Metric; LCSC C23733
J6: Conn_ARM_JTAG_SWD_10; FTSH-105-XX-YYY-DV-K-P; LCSC C19191729
R3: 100k; R_0402_1005Metric; LCSC C25741
R4, R5: 4.7k; R_0402_1005Metric; LCSC C25900
U6: STM32G431CBUx; QFN-48-1EP_7x7mm_P0.5mm_EP5.6x5.6mm; LCSC C529356

Connections:
+3V3: C17.1, C18.1, C19.1, C20.1, C21.1, C22.1, C23.1, J6.1 (VTref), R4.2, R5.2, U6.1 (VBAT), U6.20 (VREF+), U6.21 (VDDA), U6.23 (VDD), U6.35 (VDD), U6.48 (VDD); also elsewhere on the board
/MCU/HEAD_PITCH_DIR: U6.14 (PA6); also elsewhere on the board
/MCU/HEAD_PITCH_EN: U6.13 (PA5); also elsewhere on the board
/MCU/HEAD_YAW_DIR: U6.41 (PB3); also elsewhere on the board
/MCU/HEAD_YAW_EN: U6.40 (PC11); also elsewhere on the board
/MCU/I2C2_SCL: R5.1, U6.16 (PC4); also elsewhere on the board
/MCU/I2C2_SDA: R4.1, U6.5 (PF0); also elsewhere on the board
/MCU/NRST: J6.10 (~RESET), U6.7 (PG10)
/MCU/SWCLK: J6.4 (SWCLK/TCK), U6.37 (PA14)
/MCU/SWDIO: J6.2 (SWDIO/TMS), U6.36 (PA13)
/MCU/TIM1_CH1: U6.30 (PA8); also elsewhere on the board
/MCU/TIM1_CH2: U6.31 (PA9); also elsewhere on the board
/MCU/TIM1_CH3: U6.32 (PA10); also elsewhere on the board
/MCU/TIM1_CH4: U6.33 (PA11); also elsewhere on the board
/MCU/TIM2_CH1: U6.8 (PA0); also elsewhere on the board
/MCU/TIM2_CH2: U6.9 (PA1); also elsewhere on the board
/MCU/TIM2_CH3: U6.10 (PA2); also elsewhere on the board
/MCU/TIM2_CH4: U6.11 (PA3); also elsewhere on the board
/MCU/TIM3_CH1: U6.29 (PC6); also elsewhere on the board
/MCU/TIM3_CH2: U6.12 (PA4); also elsewhere on the board
/MCU/TIM3_CH3: U6.17 (PB0); also elsewhere on the board
/MCU/TIM3_CH4: U6.18 (PB1); also elsewhere on the board
/MCU/TIM4_CH1: U6.44 (PB6); also elsewhere on the board
/MCU/TIM4_CH2: U6.45 (PB7); also elsewhere on the board
/MCU/TIM4_CH3: R3.2, U6.46 (PB8); also elsewhere on the board
/MCU/TIM4_CH4: U6.47 (PB9); also elsewhere on the board
/MCU/TIM15_CH1: U6.27 (PB14); also elsewhere on the board
/MCU/TIM15_CH2: U6.28 (PB15); also elsewhere on the board
/MCU/TIM16_CH1: U6.42 (PB4); also elsewhere on the board
/MCU/TIM17_CH1: U6.15 (PA7); also elsewhere on the board
/MCU/USART3_RX: U6.24 (PB11); also elsewhere on the board
/MCU/USART3_TX: U6.22 (PB10); also elsewhere on the board
GND: C17.2, C18.2, C19.2, C20.2, C21.2, C22.2, C23.2, J6.3 (GND), J6.5 (GND), J6.9 (GNDDetect), R3.1, U6.49 (VSS); also elsewhere on the board

Notes on the sheet:
BOOT0

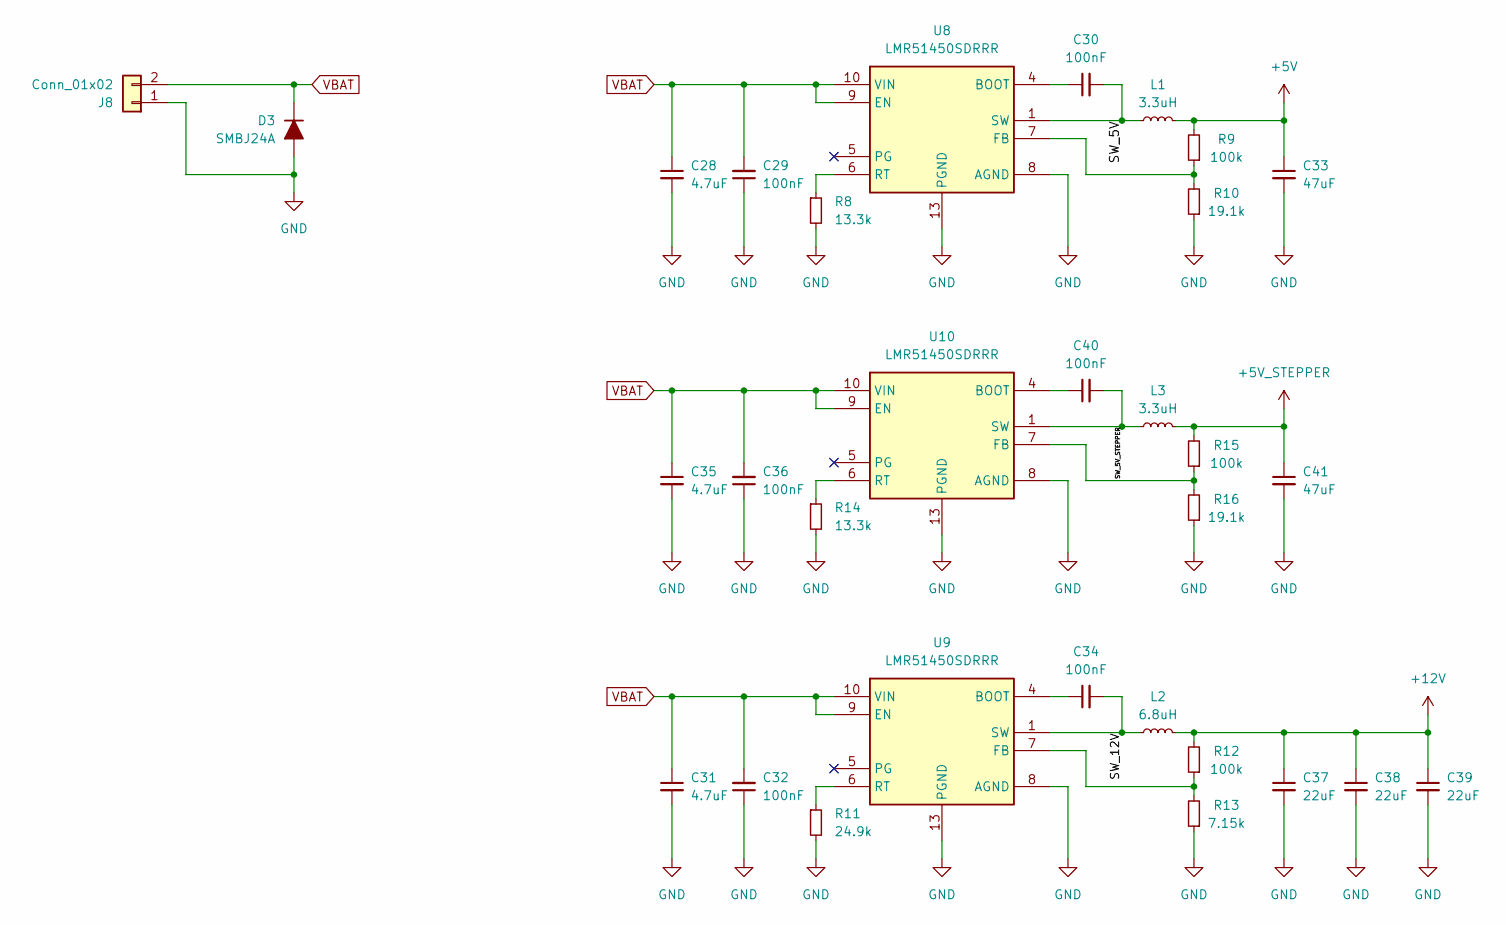
[picture p11: schematic power_regulation.kicad_sch]

Parts:
C28, C31, C35: 4.7uF; C_1206_3216Metric; LCSC C29823
C29, C30, C32, C34, C36, C40: 100nF; C_0402_1005Metric; Voltage 50V; LCSC C307331
C33, C41: 47uF; C_1210_3225Metric; LCSC C5440143
C37, C38, C39: 22uF; C_1206_3216Metric; LCSC C12891
D3: SMBJ24A; D_SMB
J8: Conn_01x02; TerminalBlock_Phoenix_PT-1,5-2-5.0-H_1x02_P5.00mm_Horizontal
L1, L3: 3.3uH; L_Chilisin_BMRx00060630; LCSC C2838324
L2: 6.8uH; ZEMS0850; LCSC C2051933
R8, R14: 13.3k; R_0402_1005Metric; LCSC C2974007
R9, R12, R15: 100k; R_0402_1005Metric; LCSC C25741
R10, R16: 19.1k; R_0402_1005Metric; LCSC C52036
R11: 24.9k; R_0402_1005Metric; LCSC C2998048
R13: 7.15k; R_0402_1005Metric; LCSC C270586
U8, U9, U10: LMR51450SDRRR; Manufacturer_Part_Number LMR51450SDRRR; Mouser Part Number 595-LMR51450SDRRR

Connections:
+5V: C33.1, L1.2, R9.2; also elsewhere on the board
+5V_STEPPER: C41.1, L3.2, R15.2; also elsewhere on the board
+12V: C37.1, C38.1, C39.1, L2.2, R12.2; also elsewhere on the board
/Power Regulation/SW_5V: C30.2, L1.1, U8.1 (SW), U8.2 (SW_2), U8.3 (SW_3)
/Power Regulation/SW_5V_STEPPER: C40.2, L3.1, U10.1 (SW), U10.2 (SW_2), U10.3 (SW_3)
/Power Regulation/SW_12V: C34.2, L2.1, U9.1 (SW), U9.2 (SW_2), U9.3 (SW_3)
GND: C28.2, C29.1, C31.2, C32.1, C33.2, C35.2, C36.1, C37.2, C38.2, C39.2, C41.2, D3.2 (A), J8.1, R8.2, R10.1, R11.2, R13.1, R14.2, R16.1, U8.8 (AGND), U8.13 (PGND), U9.8 (AGND), U9.13 (PGND), U10.8 (AGND), U10.13 (PGND); also elsewhere on the board
unnamed: C30.1, U8.4 (BOOT)
unnamed: R9.1, R10.2, U8.7 (FB)
unnamed: R8.1, U8.6 (RT)
unnamed: C34.1, U9.4 (BOOT)
unnamed: R12.1, R13.2, U9.7 (FB)
unnamed: R11.1, U9.6 (RT)
unnamed: C40.1, U10.4 (BOOT)
unnamed: R15.1, R16.2, U10.7 (FB)
unnamed: R14.1, U10.6 (RT)
VBAT: C28.1, C29.2, C31.1, C32.2, C35.1, C36.2, D3.1 (K), J8.2, U8.9 (EN), U8.10 (VIN), U8.11 (VIN_2), U8.12 (VIN_3), U9.9 (EN), U9.10 (VIN), U9.11 (VIN_2), U9.12 (VIN_3), U10.9 (EN), U10.10 (VIN), U10.11 (VIN_2), U10.12 (VIN_3); also elsewhere on the board
