benthacher/alarmbot/pcb/alarmbot.kicad_pcb

## KiCad design pcb/alarmbot.kicad_pcb (continued)

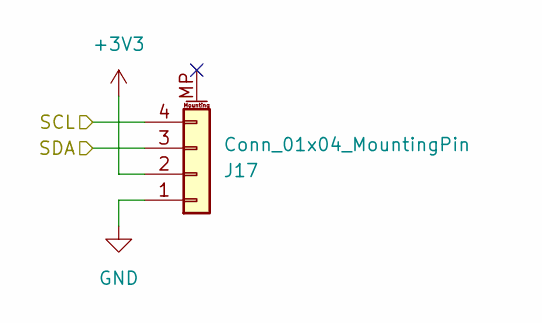
[picture p12: schematic external_i2c.kicad_sch]

Parts:
J17: Conn_01x04_MountingPin; JST_SH_BM04B-SRSS-TB_1x04-1MP_P1.00mm_Vertical; LCSC C160390

Connections:
+3V3: J17.2; also elsewhere on the board
/MCU/I2C2_SCL: J17.4; also elsewhere on the board
/MCU/I2C2_SDA: J17.3; also elsewhere on the board
GND: J17.1; also elsewhere on the board

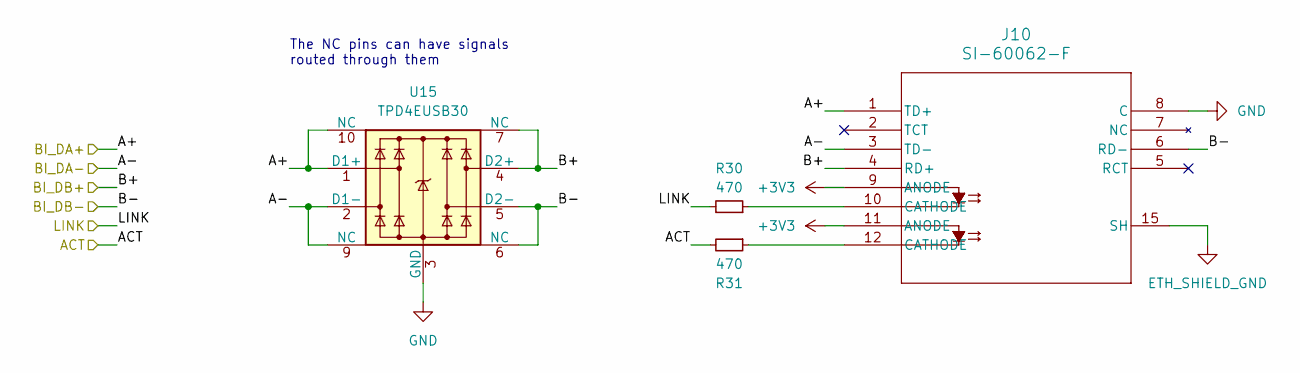
[picture p13: schematic magjack.kicad_sch]

Parts:
J10: SI-60062-F; SI-60062-F_STW
R30, R31: 470; R_0402_1005Metric; LCSC C25117
U15: TPD4EUSB30; USON-10_2.5x1.0mm_P0.5mm; LCSC C5148477

Connections:
+3V3: J10.9 (ANODE), J10.11 (ANODE); also elsewhere on the board
/cm5/ETH_A+: J10.1 (TD+), U15.1 (D1+), U15.10 (NC); also elsewhere on the board
/cm5/ETH_A-: J10.3 (TD-), U15.2 (D1-), U15.9 (NC); also elsewhere on the board
/cm5/ETH_ACT: R31.2; also elsewhere on the board
/cm5/ETH_B+: J10.4 (RD+), U15.4 (D2+), U15.7 (NC); also elsewhere on the board
/cm5/ETH_B-: J10.6 (RD-), U15.5 (D2-), U15.6 (NC); also elsewhere on the board
/cm5/ETH_LINK: R30.2; also elsewhere on the board
ETH_SHIELD_GND: J10.15 (SH), J10.16 (SH)
GND: J10.8 (C), U15.3 (GND), U15.8 (GND); also elsewhere on the board
unnamed: J10.10 (CATHODE), R30.1
unnamed: J10.12 (CATHODE), R31.1

Notes on the sheet:
The NC pins can have signals routed through them

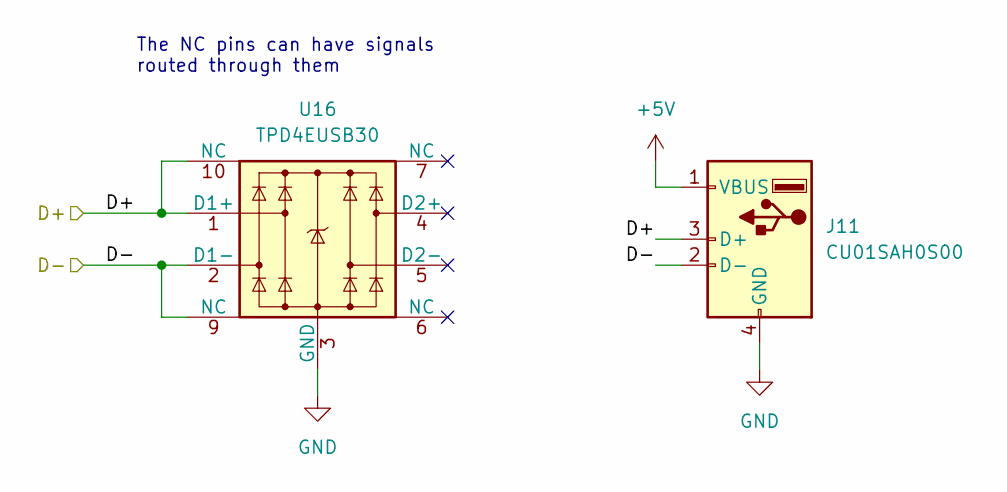
[picture p14: schematic camera_usb.kicad_sch]

Parts:
J11: CU01SAH0S00; CONN_CU01SAH0S00_CVI
U16: TPD4EUSB30; USON-10_2.5x1.0mm_P0.5mm; LCSC C5148477

Connections:
+5V: J11.1 (VBUS); also elsewhere on the board
/cm5/Camera USB/D+: J11.3 (D+), U16.1 (D1+), U16.10 (NC); also elsewhere on the board
/cm5/Camera USB/D-: J11.2 (D-), U16.2 (D1-), U16.9 (NC); also elsewhere on the board
GND: J11.4 (GND), U16.3 (GND), U16.8 (GND); also elsewhere on the board

Notes on the sheet:
The NC pins can have signals routed through them

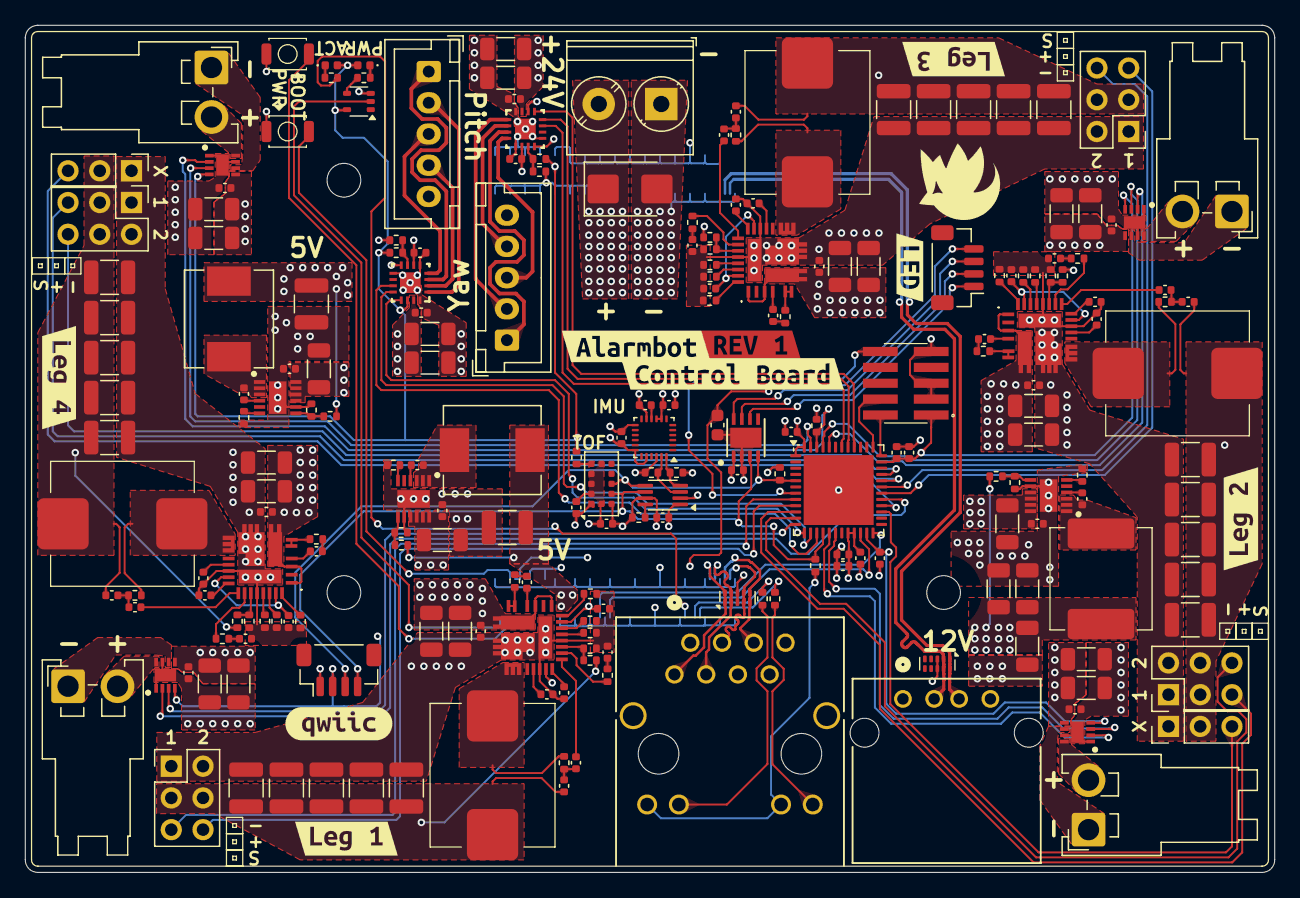
[picture p15: board alarmbot.kicad_pcb from above]

Board: 4 copper layers, 100.0 x 67.8 mm, 226 parts (1 on the bottom side), 160 nets.

Other parts of the board:
kibuzzard-67D5DC35: G***; kibuzzard-67D5DC35
kibuzzard-67D5DC97: G***; kibuzzard-67D5DC97
kibuzzard-67D6EFDF: G***; kibuzzard-67D6EFDF
kibuzzard-67D6EFED: G***; kibuzzard-67D6EFED
kibuzzard-67D6F2AE: G***; kibuzzard-67D6F2AE
kibuzzard-67D6F2CD: G***; kibuzzard-67D6F2CD
kibuzzard-67D6F2E9: G***; kibuzzard-67D6F2E9
kibuzzard-67D6F300: G***; kibuzzard-67D6F300
kibuzzard-67D8C3DC: G***; kibuzzard-67D8C3DC
