benthacher/alarmbot/pcb/alarmbot.ioc

Mcu.UserName=STM32G431CBUx
PA0.Signal=S_TIM2_CH1
PA1.Signal=S_TIM2_CH2
PA10.Signal=S_TIM1_CH3
PA11.Signal=S_TIM1_CH4
PA13.Signal=SYS_JTMS-SWDIO
PA14.Signal=SYS_JTCK-SWCLK
PA2.Signal=S_TIM2_CH3
PA3.Signal=S_TIM2_CH4
PA4.Signal=S_TIM3_CH2
PA5.GPIO_Label=HEAD_PITCH_EN
PA5.Signal=GPIO_Output
PA6.GPIO_Label=HEAD_PITCH_DIR
PA6.Signal=GPIO_Output
PA7.Signal=S_TIM17_CH1
PA8.Signal=S_TIM1_CH1
PA9.Signal=S_TIM1_CH2
PB0.Signal=S_TIM3_CH3
PB1.Signal=S_TIM3_CH4
PB10.Signal=USART3_TX
PB11.Signal=USART3_RX
PB14.Signal=S_TIM15_CH1
PB15.Signal=S_TIM15_CH2
PB3.GPIO_Label=HEAD_YAW_DIR
PB3.Signal=GPIO_Output
PB4.Signal=S_TIM16_CH1
PB6.Signal=S_TIM4_CH1
PB7.Signal=S_TIM4_CH2
PB8-BOOT0.Signal=S_TIM4_CH3
PB9.Signal=S_TIM4_CH4
PC11.GPIO_Label=HEAD_YAW_EN
PC11.Signal=GPIO_Output
PC13.GPIO_Label=LED_R
PC13.Signal=GPIO_Output
PC14-OSC32_IN.GPIO_Label=LED_G
PC14-OSC32_IN.Signal=GPIO_Output
PC15-OSC32_OUT.GPIO_Label=LED_B
PC15-OSC32_OUT.Signal=GPIO_Output
PC4.Signal=I2C2_SCL
PC6.Signal=S_TIM3_CH1
PF0-OSC_IN.Signal=I2C2_SDA
