benthacher/alarmbot/(commit log)

2025-03-19 Added custom libraries to pcb
2025-03-19 Cleaned up 3d model paths
    [alarmbot.kicad_pcb]
2025-03-19 Added pcb render
